flighttronics/almtracker1/img/almtracker_1_schematic_1_2.jpg

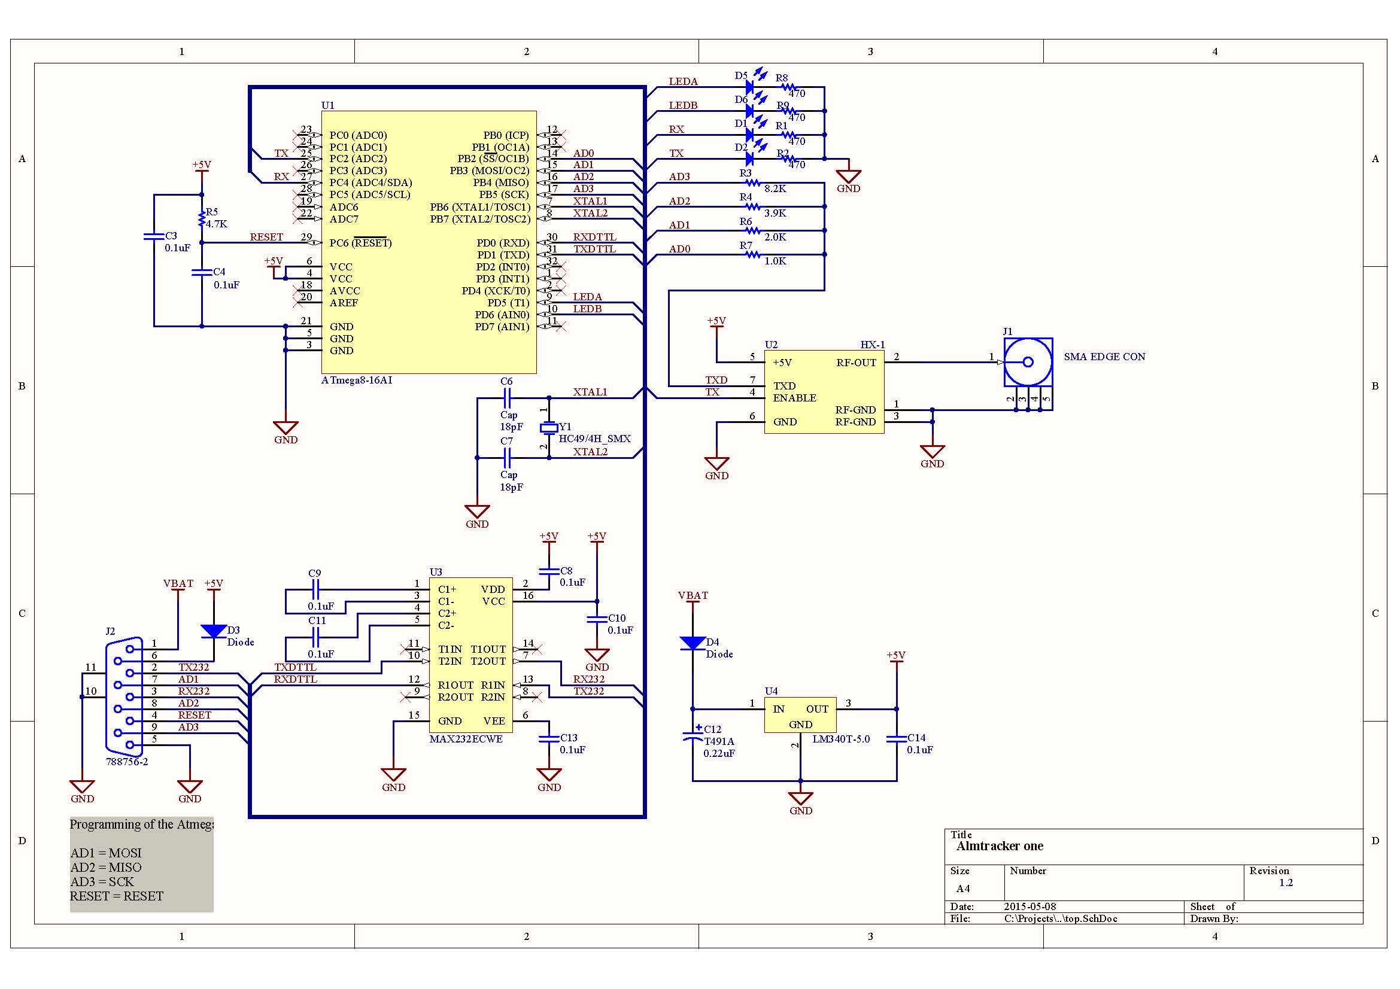
img/almtracker_1_schematic_1_2.jpg
