flighttronics/almtracker1/schematics/almtracker1_v1.2.pdf

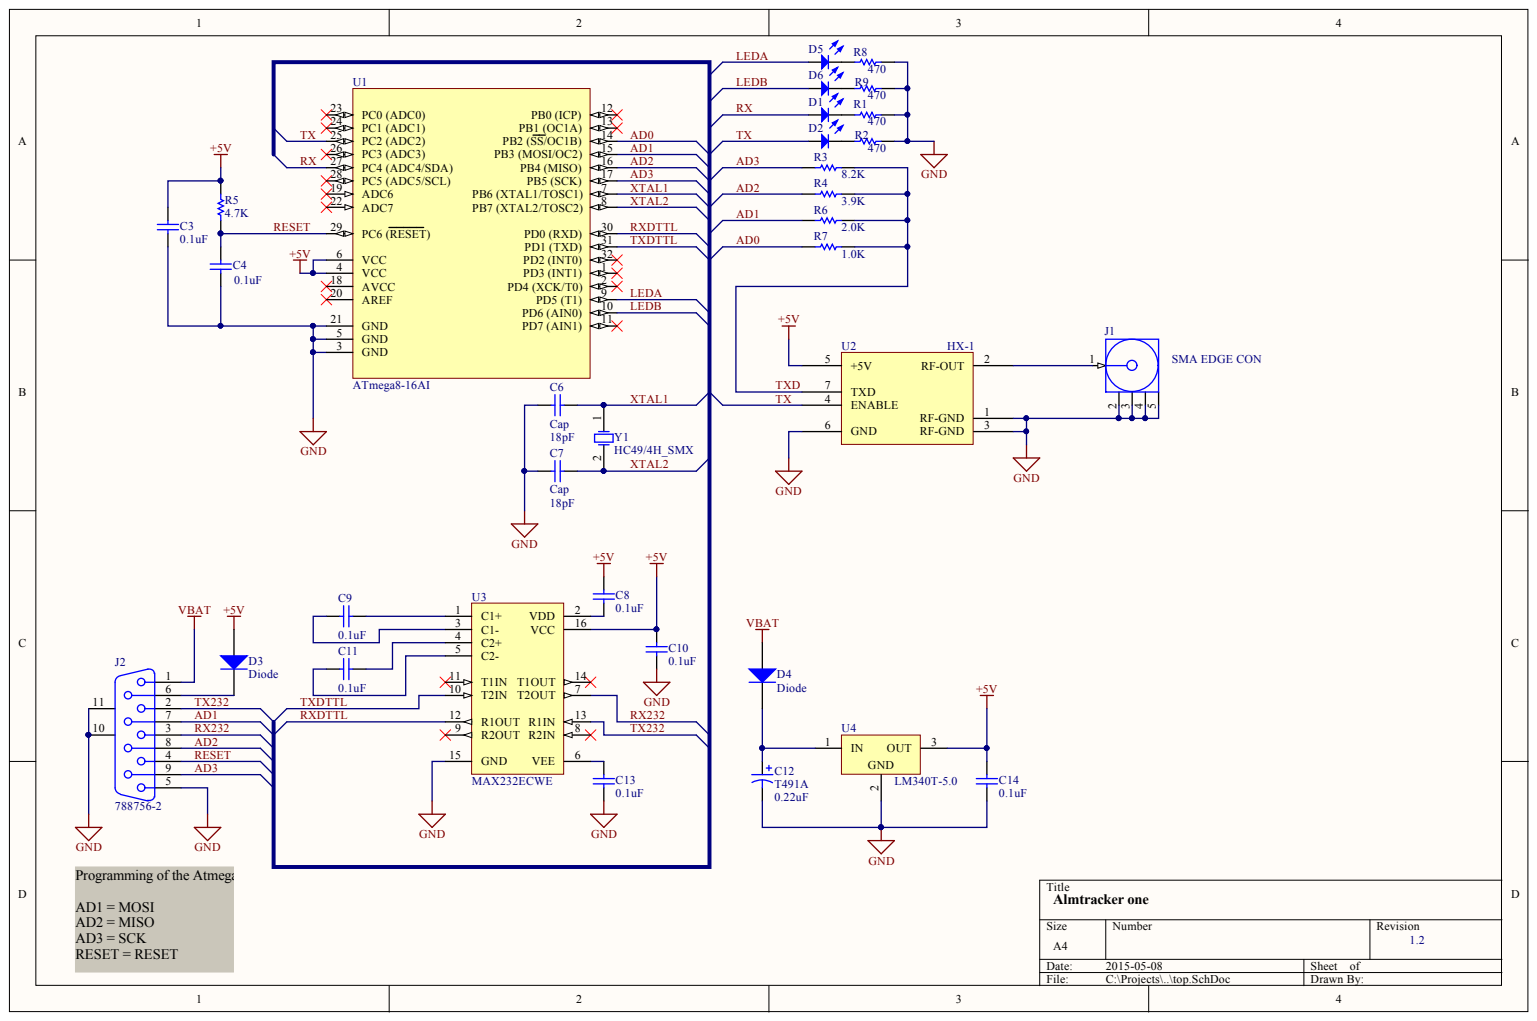
[picture p4: page 1]

1 8 | | 2
