flighttronics/almtracker1/schematics/almtracker1_v1.1.pdf

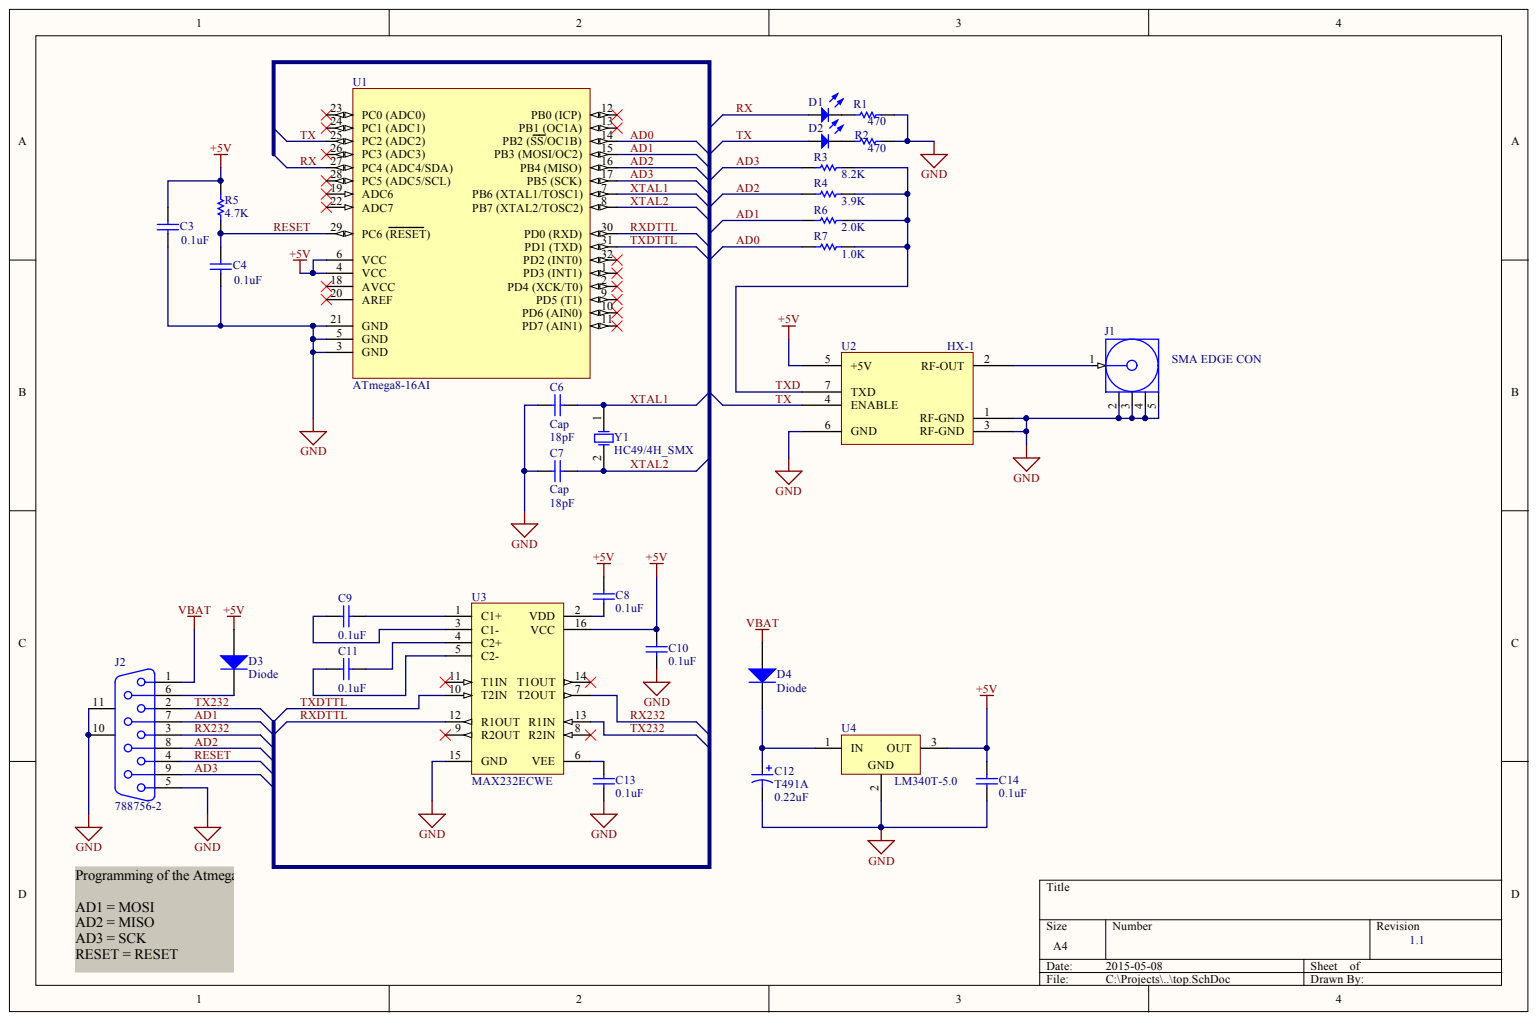
[picture p5: page 1]

1 8 | | 2
