flighttronics/almtracker1/(commit log)

2014-06-05 Fixed issues on corrupt eeprom
    [Main.c]
2014-07-19 Added LED functionality for HW 1.2
